Bshinoski/threshold-device/hardware/thresholdboard.brd

## EAGLE design hardware/thresholdboard.brd (2025-08-26)

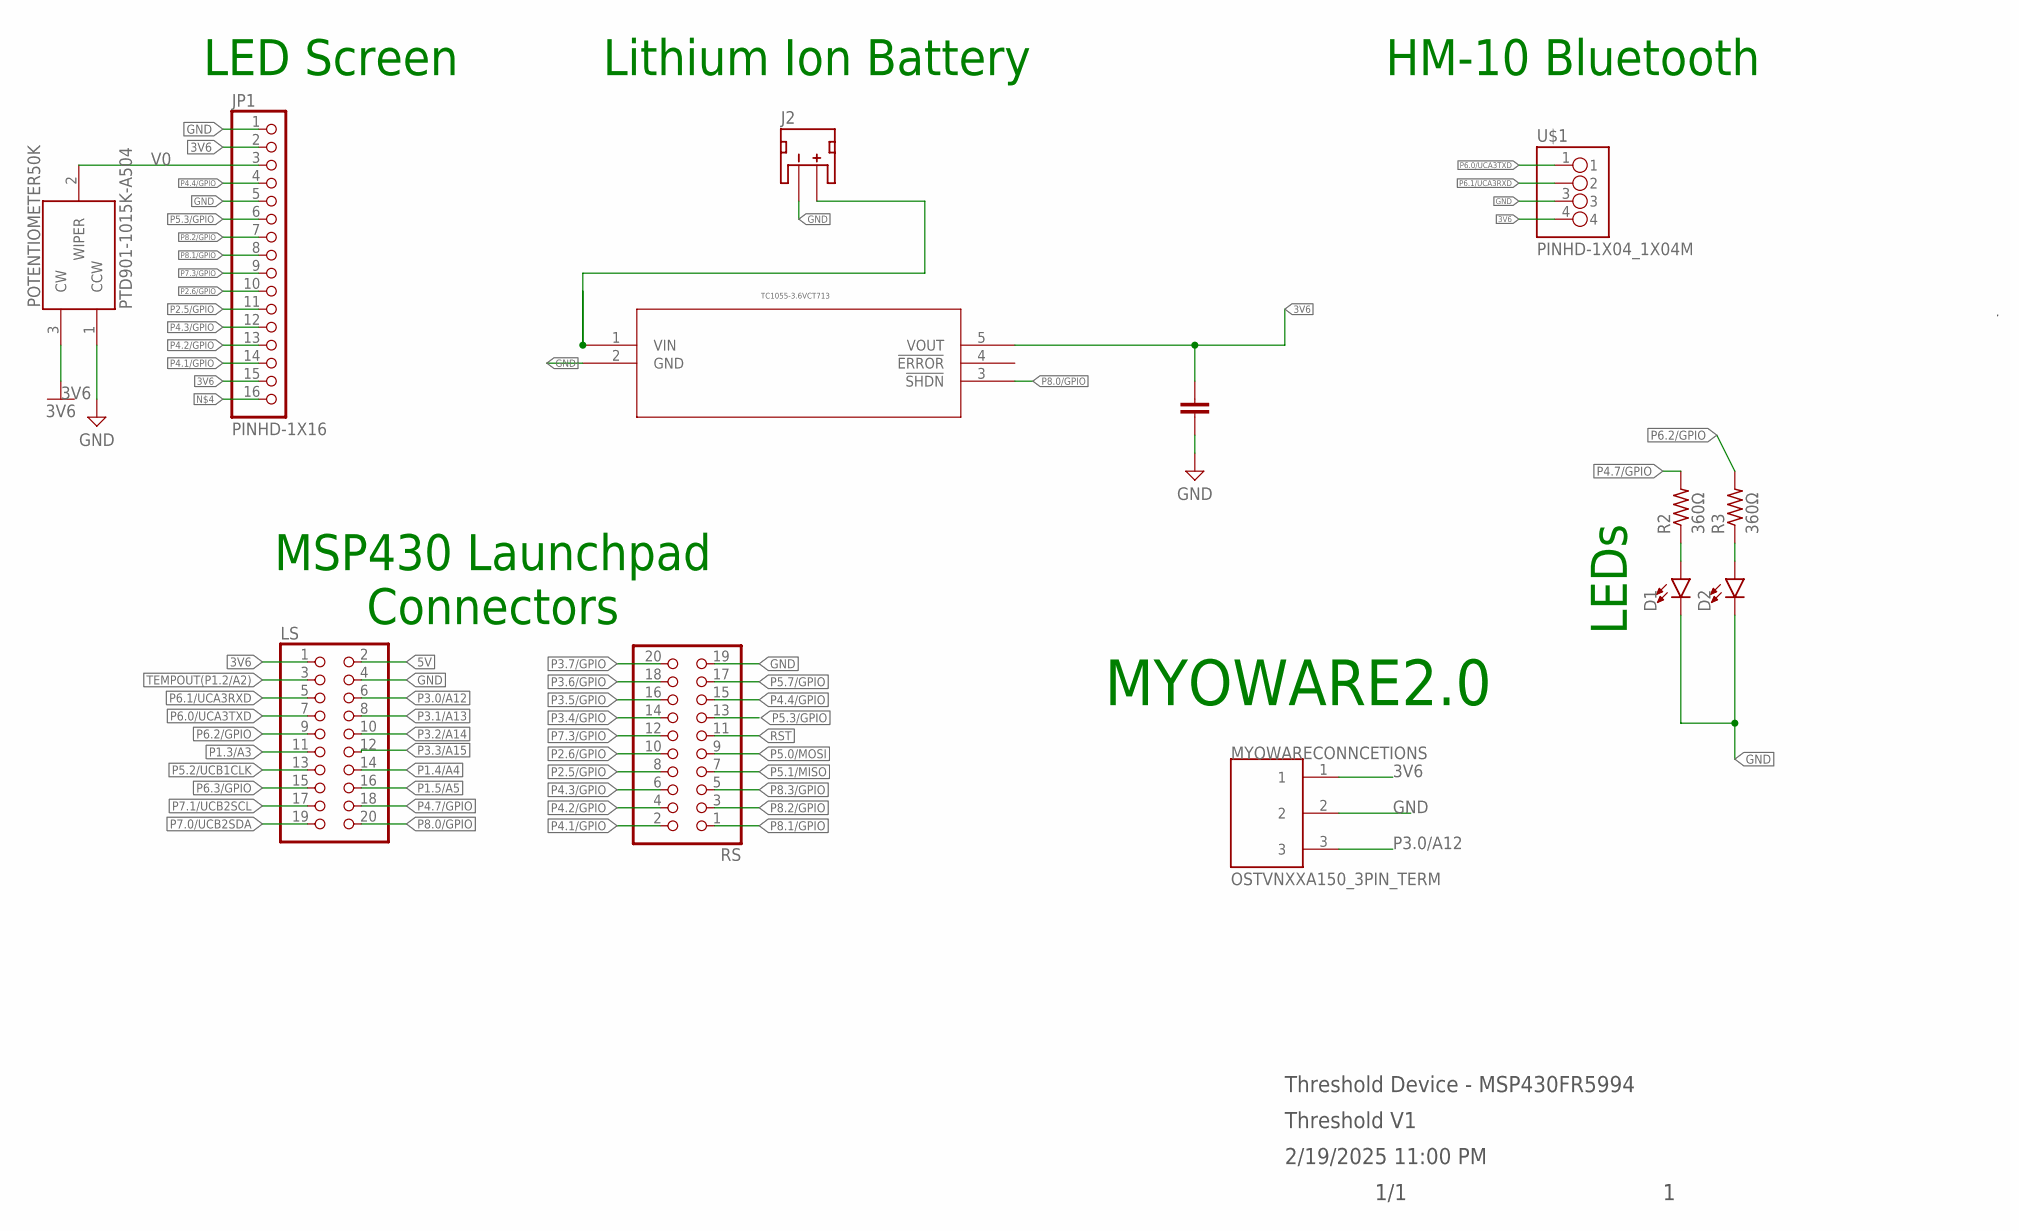
[picture p3: schematic thresholdboard.sch, sheet 1]

Parts:
C7: C_CHIP-0402(1005-METRIC); CAPC1005X60
D1, D2: LED3MM; LED_3MM
J2: JST_2MM_MALE; JST-2-SMD
JP1: PINHD-1X16; 1X16
LS: PINHD-2X10; 2X10
MYOWARECONNCETIONS: OSTVNXXA150_3PIN_TERM; OSTVNXXA150
POTENTIOMETER50K: PTD901-1015K-A504; PTD9011015KA504
R2, R3: 360Ω; R0805
RS: PINHD-2X10; 2X10
U1: TC1055-3.6VCT713; SOT-23-5_MC_MCH
U$1: PINHD-1X04_1X04M; 1X04

Connections:
3V6: C7.1, JP1.2, JP1.15, LS.1, MYOWARECONNCETIONS.1, POTENTIOMETER50K.3 (CW), U1.5 (VOUT), U$1.4
5V: LS.2
GND: C7.2, D1.K (C), D2.K (C), J2.1 (-), JP1.1, JP1.5, LS.4, MYOWARECONNCETIONS.2, POTENTIOMETER50K.1 (CCW), RS.19, U1.2 (GND), U$1.3
unnamed: D1.A, R2.1
unnamed: D2.A, R3.1
P1.3/A3: LS.11
P1.4/A4: LS.14
P1.5/A5: LS.16
P2.5/GPIO: JP1.11, RS.8
P2.6/GPIO: JP1.10, RS.10
P3.0/A12: LS.6, MYOWARECONNCETIONS.3
P3.1/A13: LS.8
P3.2/A14: LS.10
P3.3/A15: LS.12
P3.4/GPIO: RS.14
P3.5/GPIO: RS.16
P3.6/GPIO: RS.18
P3.7/GPIO: RS.20
P4.1/GPIO: JP1.14, RS.2
P4.2/GPIO: JP1.13, RS.4
P4.3/GPIO: JP1.12, RS.6
P4.4/GPIO: JP1.4, RS.15
P4.7/GPIO: LS.18, R2.2
P5.0/MOSI: RS.9
P5.1/MISO: RS.7
P5.2/UCB1CLK: LS.13
P5.3/GPIO: JP1.6, RS.13
P5.7/GPIO: RS.17
P6.0/UCA3TXD: LS.7, U$1.1
P6.1/UCA3RXD: LS.5, U$1.2
P6.2/GPIO: LS.9, R3.2
P6.3/GPIO: LS.15
P7.0/UCB2SDA: LS.19
P7.1/UCB2SCL: LS.17
P7.3/GPIO: JP1.9, RS.12
P8.0/GPIO: LS.20, U1.3 (!SHDN)
P8.1/GPIO: JP1.8, RS.1
P8.2/GPIO: JP1.7, RS.3
P8.3/GPIO: RS.5
RST: RS.11
TEMPOUT(P1.2/A2): LS.3
V0: JP1.3, POTENTIOMETER50K.2 (WIPER)
VIN: J2.2 (+), U1.1 (VIN)

Notes on the sheet:
LEDs
MSP430 Launchpad Connectors
LED Screen
Lithium Ion Battery
HM-10 Bluetooth
MYOWARE2.0
Threshold Device - MSP430FR5994
Threshold V1
2/19/2025 11:00 PM
1/1

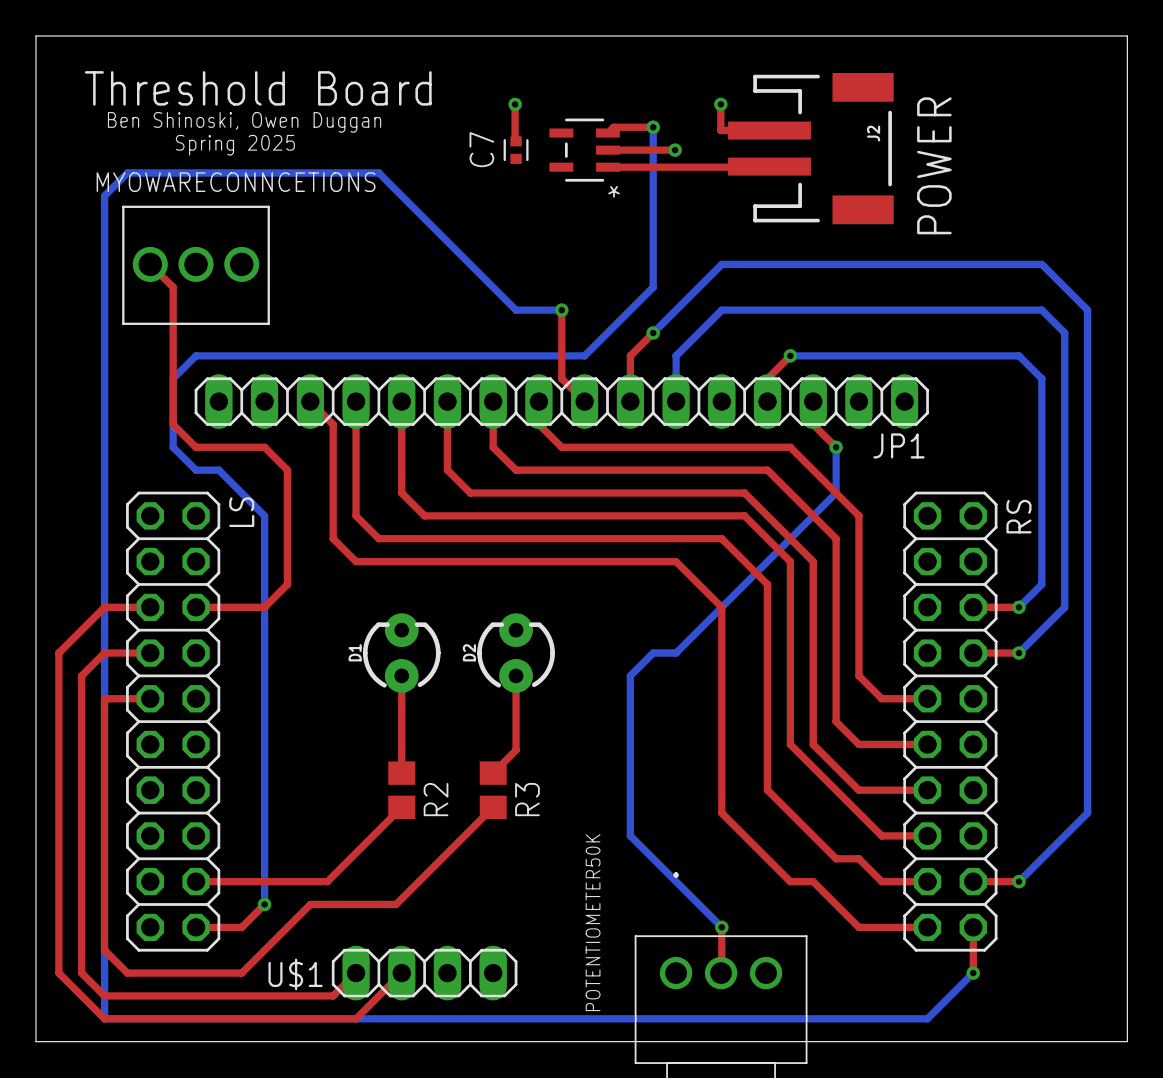
[picture p4: board thresholdboard.brd from above]

Board: 2 copper layers, 60.6 x 55.9 mm, 13 parts (0 on the bottom side), 21 nets.
